ethergrade/VORTEX_AX-128/docs/05_KEYMAP_V1_0.md

# 05 — VORTEX AX-128 Keymap V1.0

**Status: FROZEN unless explicitly revised.**

| Row | 1 | 2 | 3 | 4 | 5 | 6 | 7 | 8 | 9 | 10 | 11 | 12 | 13 | 14 | 15 | 16 |
|---|---|---|---|---|---|---|---|---|---|---|---|---|---|---|---|---|
| **A** | LAYER 1 | LAYER 2 | LAYER 3 | LAYER 4 | MUTE | SOLO | COPY | PASTE | DRUM | GRANULAR | SYNTH | ANALOG | FX | SEQ | MIX | SYSTEM |
| **B** | STEP 1 | STEP 2 | STEP 3 | STEP 4 | STEP 5 | STEP 6 | STEP 7 | STEP 8 | STEP 9 | STEP 10 | STEP 11 | STEP 12 | STEP 13 | STEP 14 | STEP 15 | STEP 16 |
| **C** | BD | BD2 | SNARE | CLAP | RIM | LT | MT | HT | CLOSED HH | OPEN HH | CRASH | RIDE | COWBELL | PERC 1 | PERC 2 | USER DRUM |
| **D** | FREEZE | HOLD/GATE | RETRIGGER | REVERSE | CAPTURE | RESAMPLE | SYNC/FREE | RANDOMIZE | POSITION - | POSITION + | LENGTH - | LENGTH + | DENSITY - | DENSITY + | PITCH - | PITCH + |
| **E** | ENV SQUARE | ENV TRAPEZOID | ENV HANN | ENV GAUSSIAN | ENV TRIANGLE | SPRAY - | SPRAY + | CHAOS - | CHAOS + | SPACE - | SPACE + | REVERSE % | SOURCE - | SOURCE + | BANK - | BANK + |
| **F** | NOTE 1 | NOTE 2 | NOTE 3 | NOTE 4 | NOTE 5 | NOTE 6 | NOTE 7 | NOTE 8 | NOTE 9 | NOTE 10 | NOTE 11 | NOTE 12 | NOTE 13 | NOTE 14 | NOTE 15 | NOTE 16 |
| **G** | CHORUS | FLANGER | PHASER | TREMOLO | VIBRATO | DELAY | REVERB | DRIVE | BITCRUSH | WAVEFOLD | STUTTER | TAPE STOP | REVERSE FX | GLITCH | FX FREEZE | FX BYPASS/KILL |
| **H** | PLAY/STOP | RECORD | OVERDUB | TAP TEMPO | TEMPO - | TEMPO + | PATTERN - | PATTERN + | SCENE 1 | SCENE 2 | SCENE 3 | SCENE 4 | SCENE 5 | SCENE 6 | SCENE 7 | SCENE 8 |

## First row rule

The first eight keys of Row A are specifically:

```text
A1 LAYER 1
A2 LAYER 2
A3 LAYER 3
A4 LAYER 4
A5 MUTE
A6 SOLO
A7 COPY
A8 PASTE
```

The remaining eight keys select major GUI pages.

## Note row

F1–F16 are scale-locked performance pads.

They should follow:

- selected root;
- selected scale;
- octave/range settings.

The GUI should show actual note names so the instrument can be played by ear without requiring conventional keyboard fingering.
