ethergrade/VORTEX_AX-128/assets/Arduino_screenshots/Screenshot 2026-09-28 alle 19.35.44.png

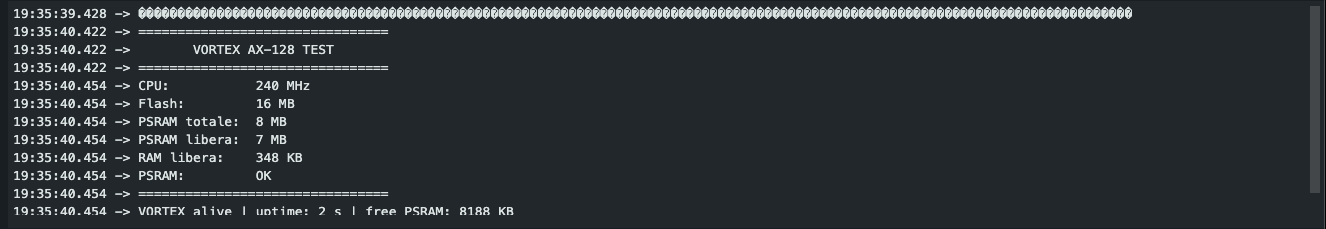
assets/Arduino_screenshots/Screenshot 2026-09-28 alle 19.35.44.png
