ethergrade/VORTEX_AX-128/assets/Displays/IMG_8864_no_metadata.jpg

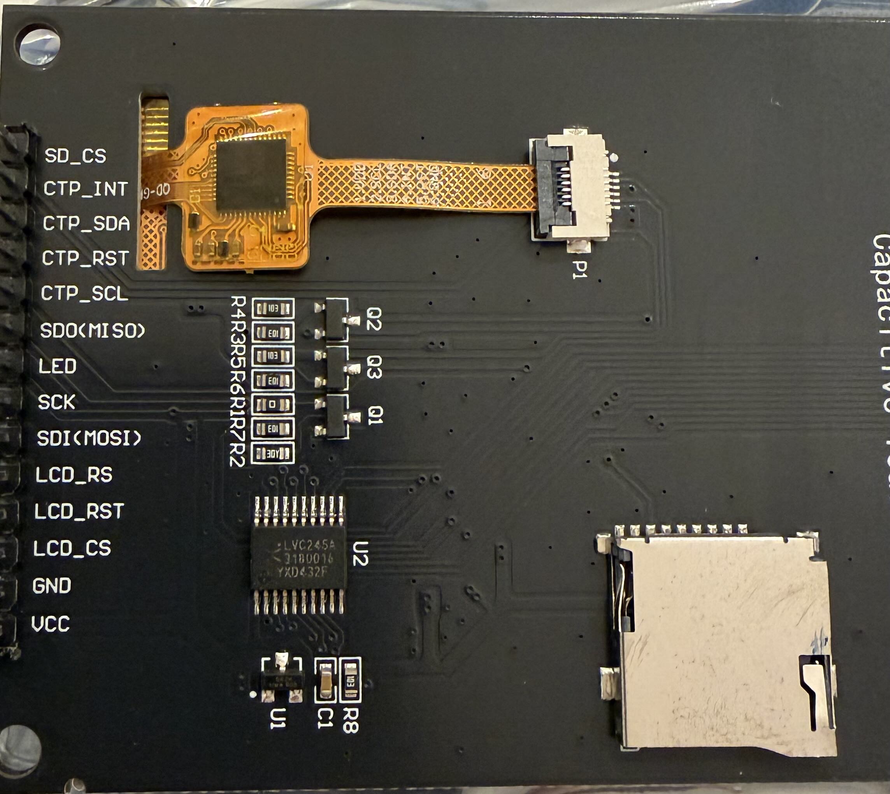
assets/Displays/IMG_8864_no_metadata.jpg
