ethergrade/VORTEX_AX-128/assets/EK128/IMG_8587.jpeg

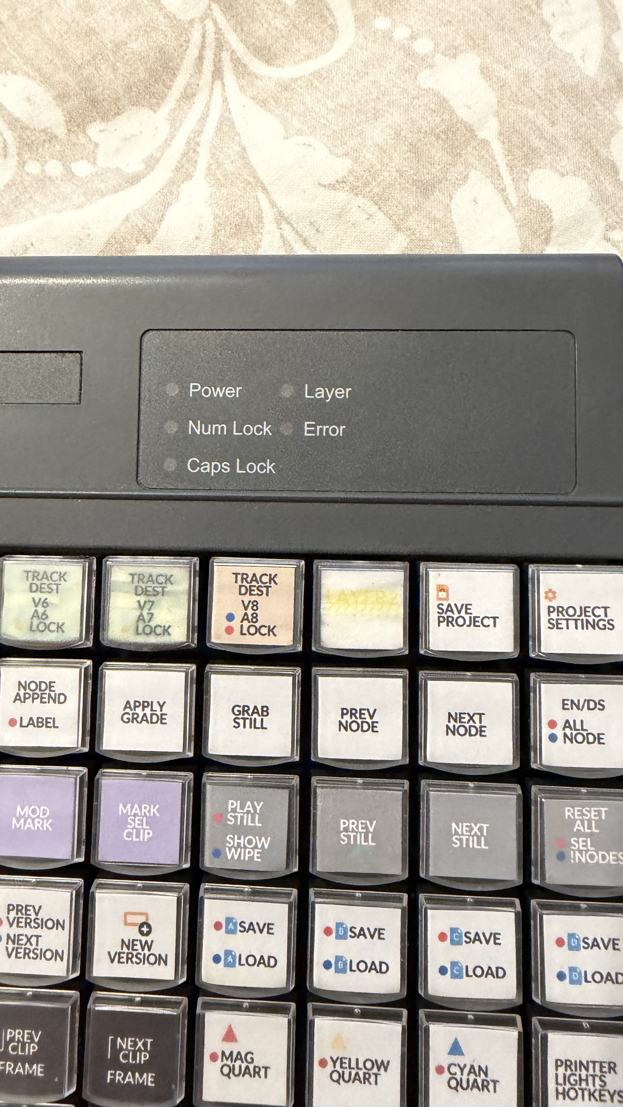
assets/EK128/IMG_8587.jpeg
