ethergrade/VORTEX_AX-128/assets/EK128/IMG_8595.jpeg

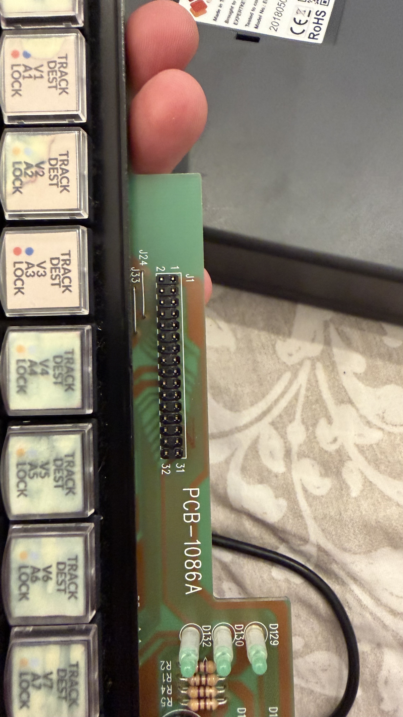
assets/EK128/IMG_8595.jpeg
