ethergrade/VORTEX_AX-128/assets/ESP32_Freenove/IMG_8728.jpeg

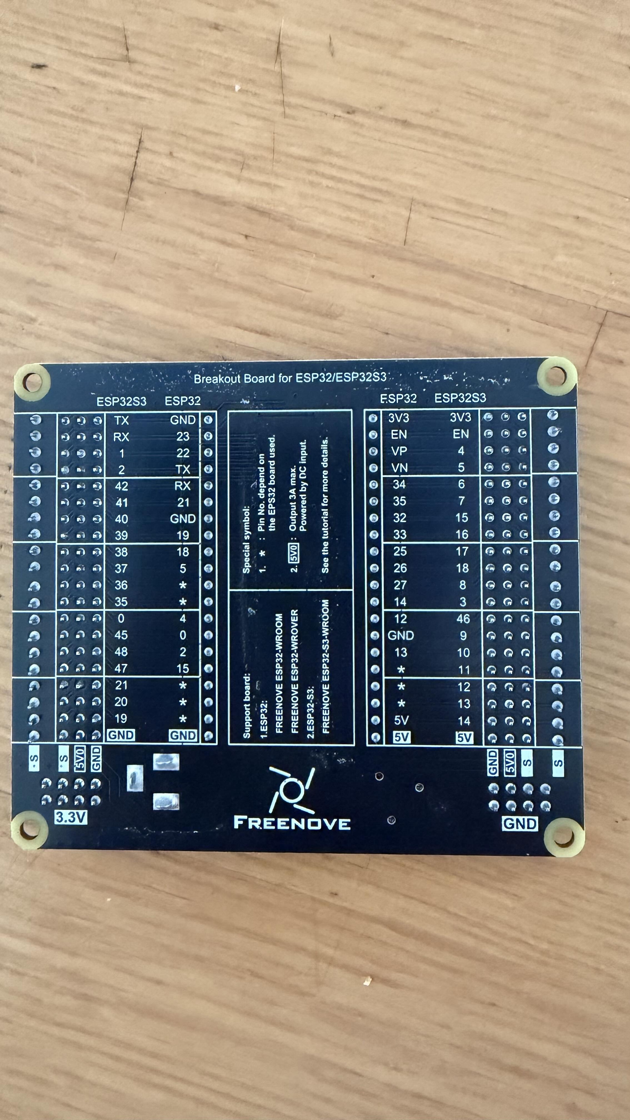
assets/ESP32_Freenove/IMG_8728.jpeg
