ethergrade/VORTEX_AX-128/assets/GUI_references/IMG_8709.png

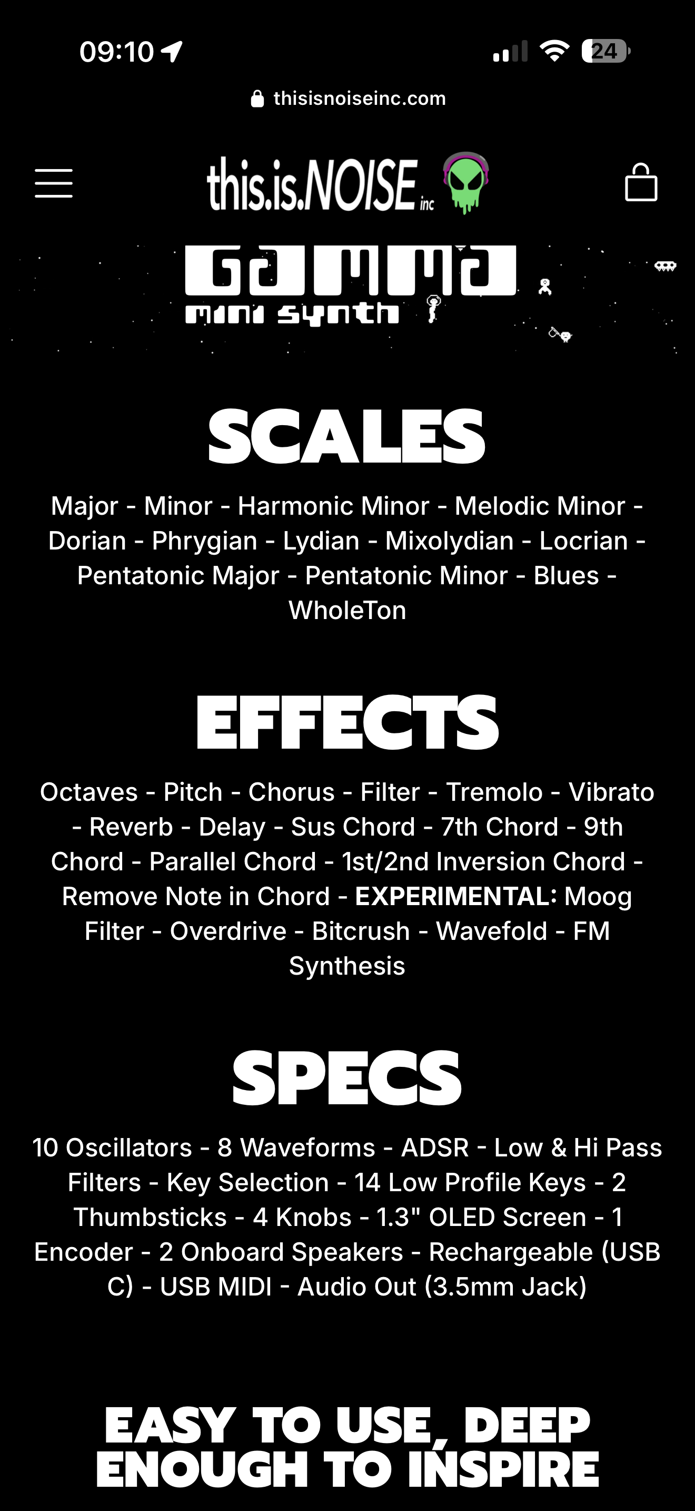
assets/GUI_references/IMG_8709.png
