ethergrade/VORTEX_AX-128/assets/GUI_references/IMG_8713.png

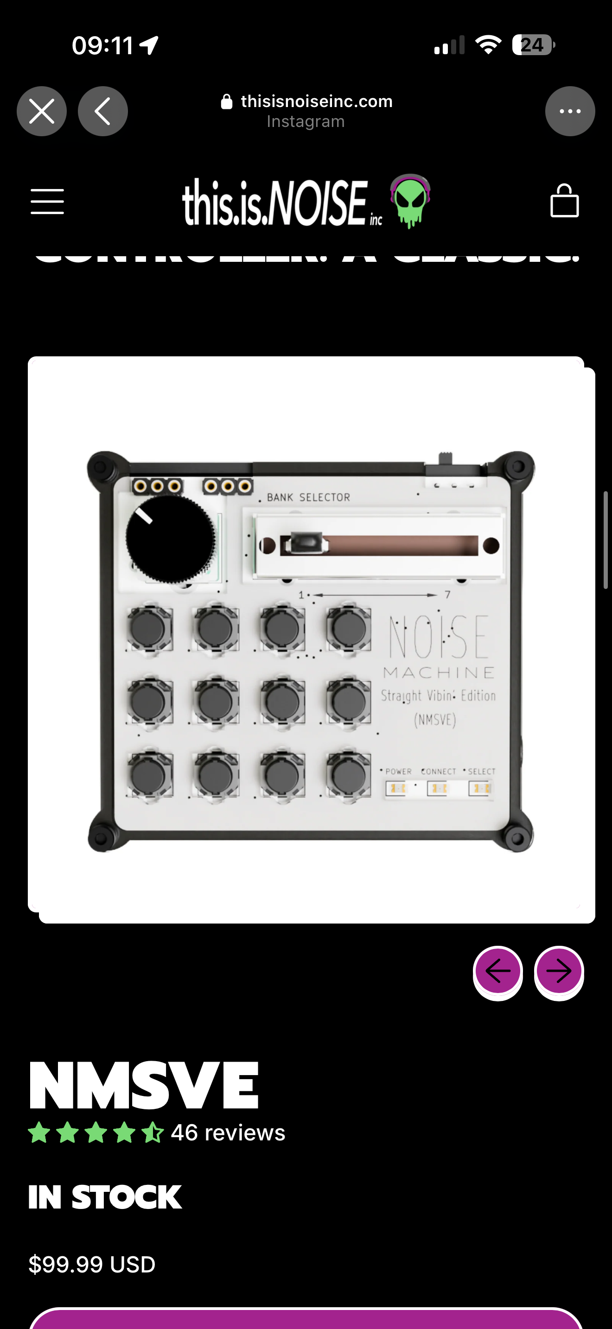
assets/GUI_references/IMG_8713.png
