ethergrade/VORTEX_AX-128/assets/Modules/IMG_8862_no_metadata.jpg

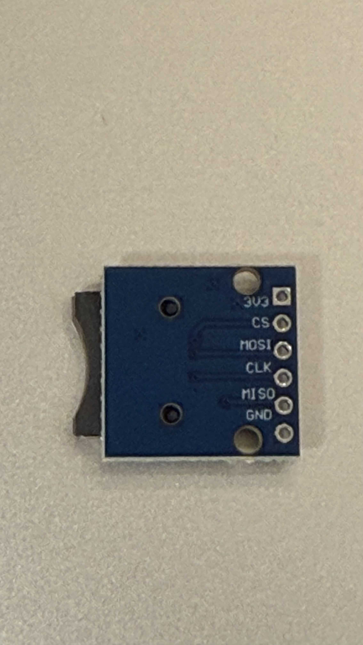
assets/Modules/IMG_8862_no_metadata.jpg
