ethergrade/VORTEX_AX-128/assets/Modules/IMG_8863_no_metadata.jpg

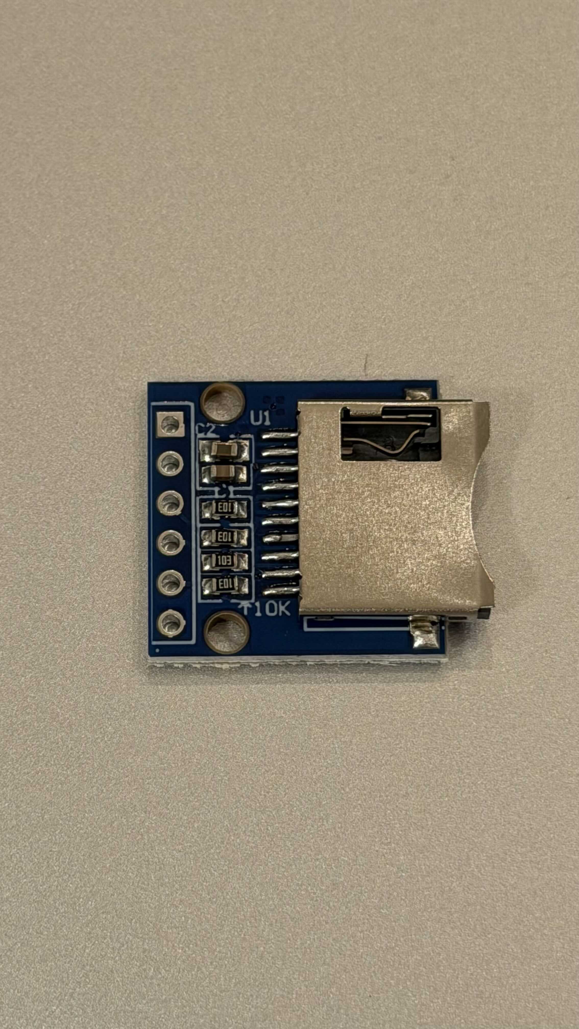
assets/Modules/IMG_8863_no_metadata.jpg
