ethergrade/VORTEX_AX-128/assets/test_evidence/2026-10-02/ek128-full-matrix/RESULT.md

# EK-128 full matrix — user-reported result

The user reported on 2026-10-02: “funzionano tutti i tasti, premuto e rilasciato.” The active scanner is configured for all eight rows and sixteen columns through the CD74HC4067. This records reported press and release events for all 128 physical keys.

The user had previously identified a reversed VCC/GND connection on the mux after it became very hot. The full-key report followed that diagnosis. The user then confirmed: “confermo corrispondenza esatta, pressioni multiple funzionano, e multiplexer ok temperatura”.

The reported result covers exact physical key-to-coordinate correspondence, multiple presses through the mux, and normal operating temperature. No Serial Monitor capture, photo, temperature measurement, or exhaustive key-combination matrix was supplied.
