ethergrade/VORTEX_AX-128/(commit log)

2026-09-30 docs: add EK-128 connector wiring table
2026-09-30 docs: add local Flaticon keymap review index
    [pack-correlation.csv]
2026-10-01 docs: clarify complete EK-128 J1 wiring
2026-10-01 feat: add first SPI display wiring and diagnostic
2026-10-02 fix: wait for USB CDC before microSD diagnostics
    [VortexSDTest.ino]
2026-10-02 fix: start microSD diagnostics without CDC gate
    [VortexSDTest.ino]
2026-10-02 fix: route ESP32 diagnostics through USB UART
    [VortexSDTest.ino]
2026-10-02 docs: record persistent microSD mount failure
2026-10-02 docs: clarify microSD begin failure stages
2026-10-02 docs: record ESP32 verbose GPIO report
2026-10-02 docs: prioritize SPI display bench test
2026-10-02 fix: initialize LCD control pins before use
    [VortexDisplayTest.ino]
2026-10-02 docs: record display success and 9V rail setup
2026-10-02 docs: plan display SD sample storage
2026-10-02 fix: reserve GPIO21 for display reset
    [VortexDisplayTest.ino, VortexSDTest.ino]
